khushitpratikshah/openear/enclosure/stl/pod_exploded.png

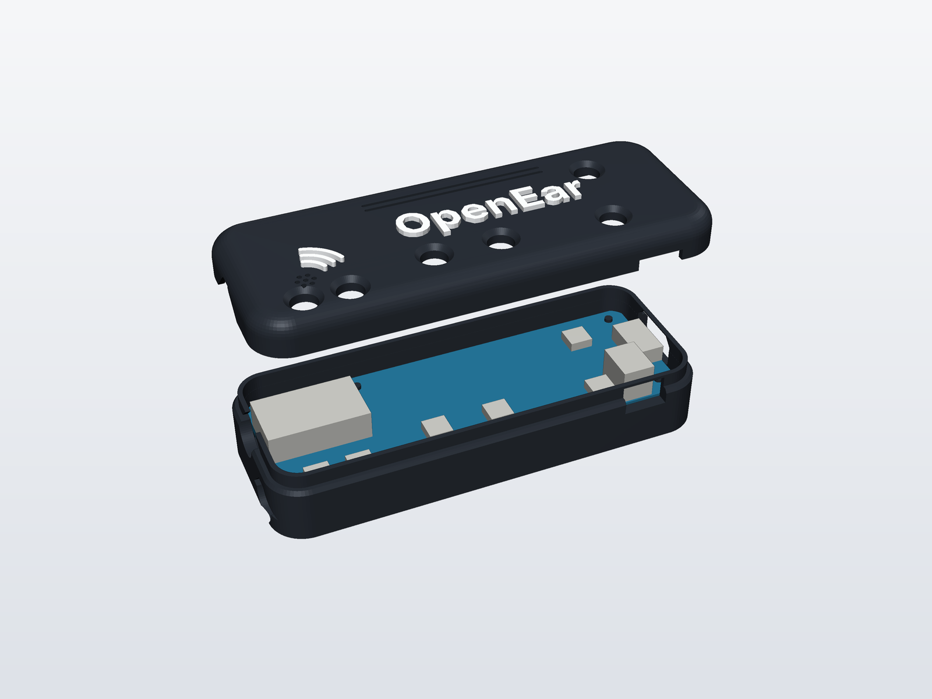
enclosure/stl/pod_exploded.png
