khushitpratikshah/openear/enclosure/stl/pod_hero.png

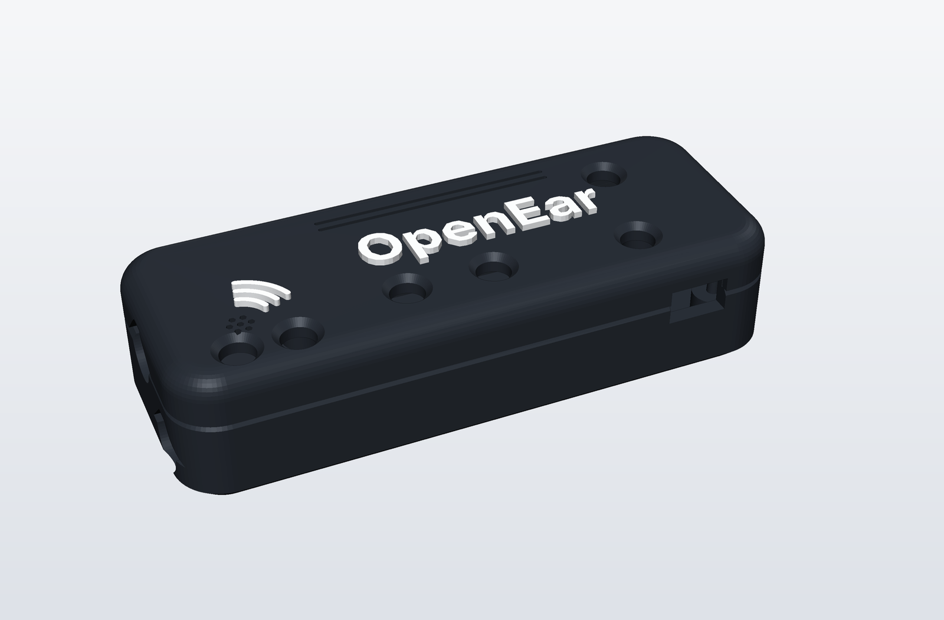
enclosure/stl/pod_hero.png
