khushitpratikshah/openear/diagrams/late_blocks.png

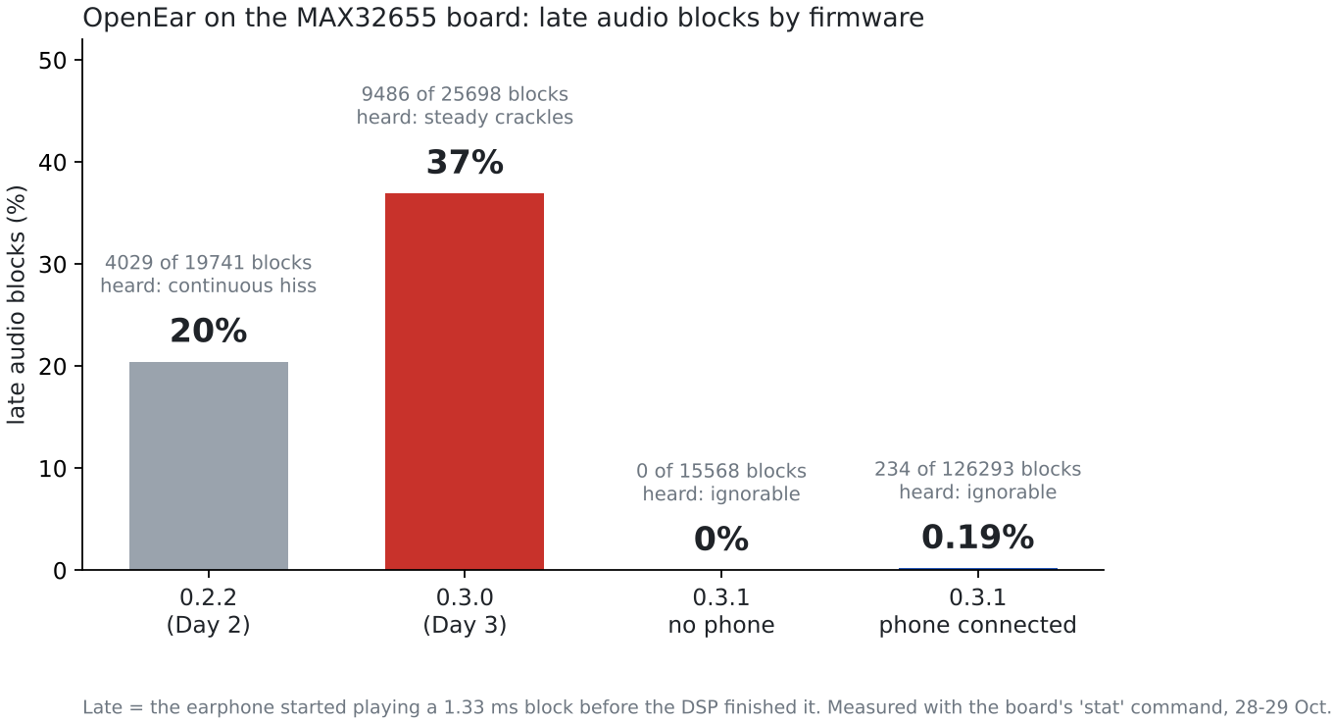
diagrams/late_blocks.png
