khushitpratikshah/openear/diagrams/latency.png

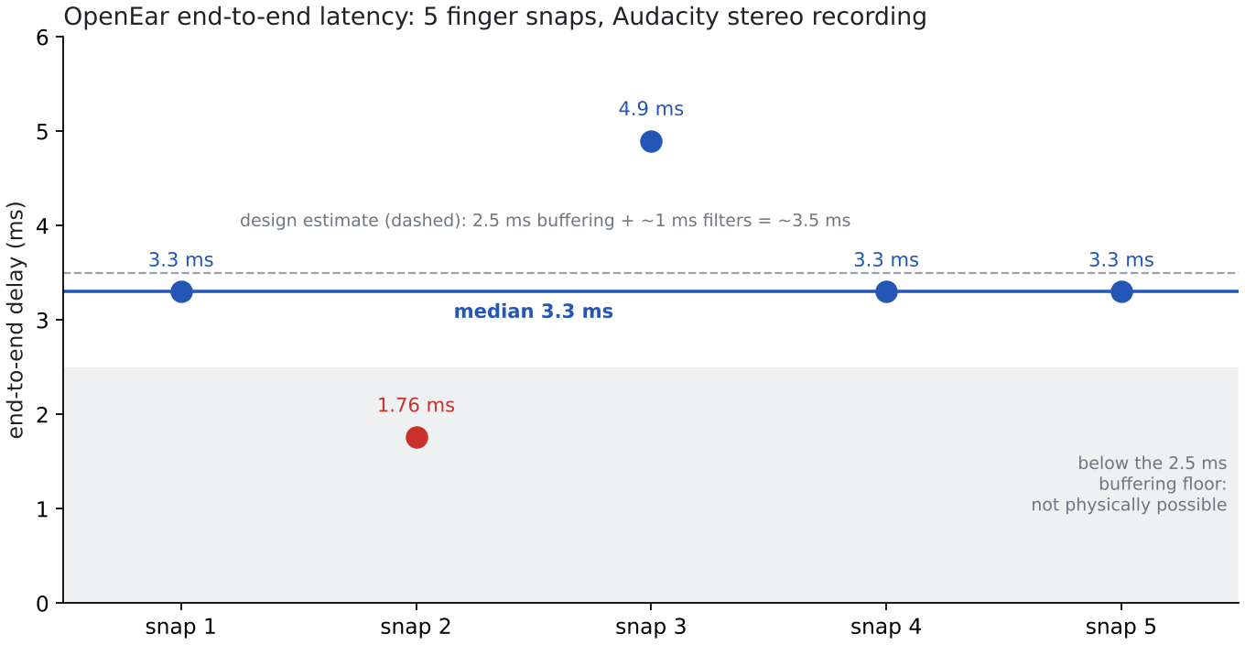
diagrams/latency.png
