khushitpratikshah/openear/diagrams/phase_lock.png

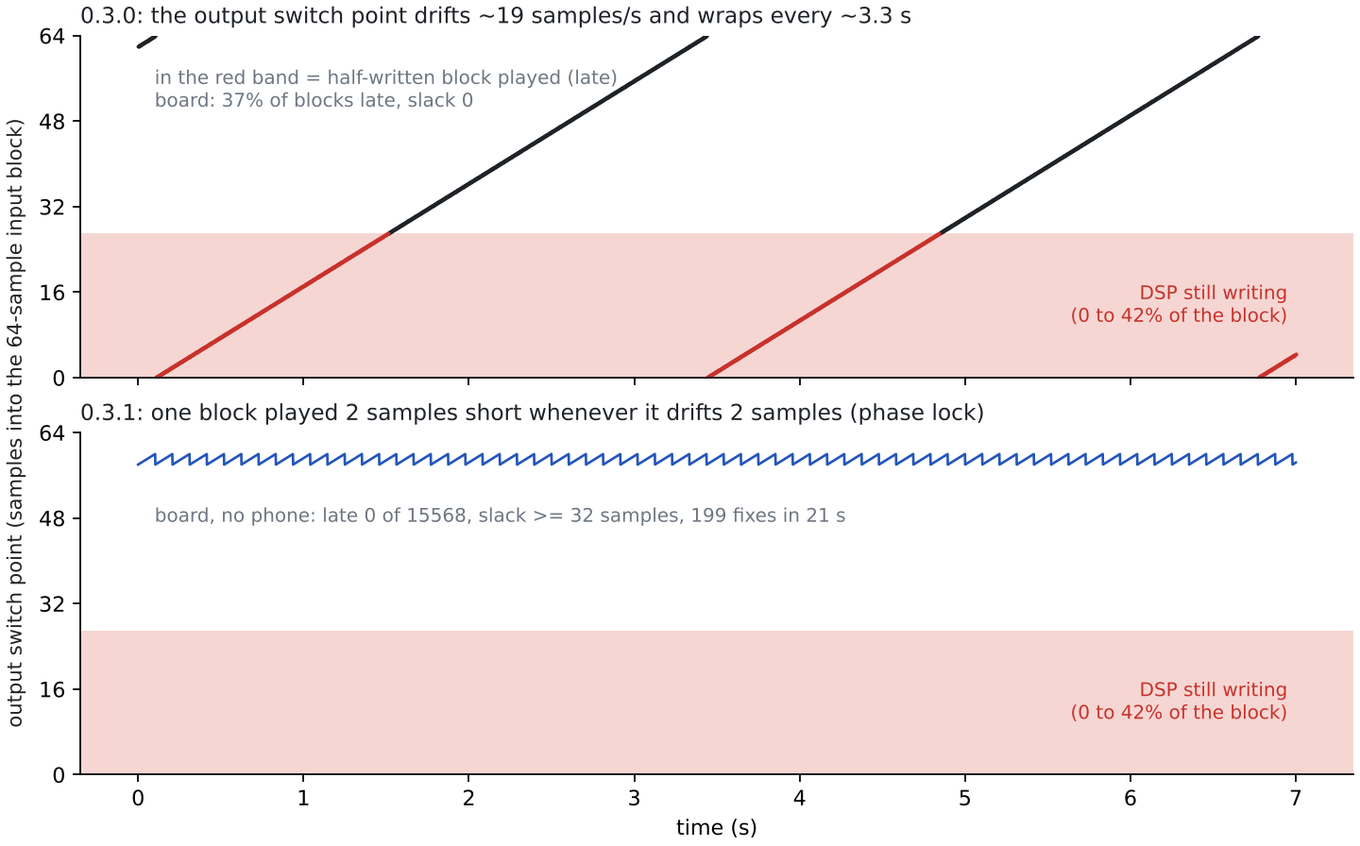
diagrams/phase_lock.png
