khushitpratikshah/openear/diagrams/signal_flow.png

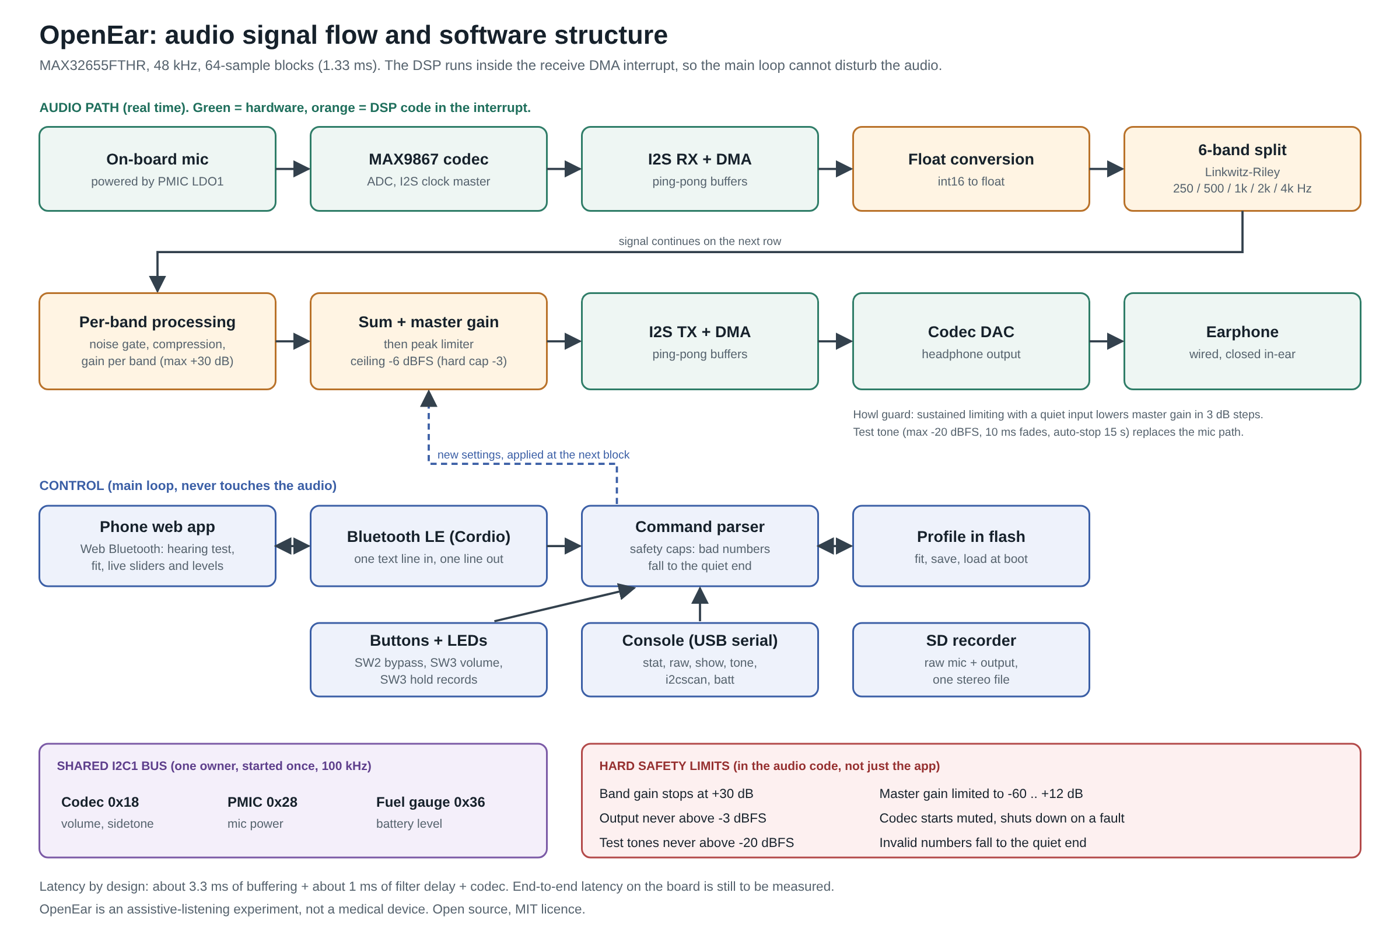
diagrams/signal_flow.png
