khushitpratikshah/openear/enclosure/stl/pod_back.png

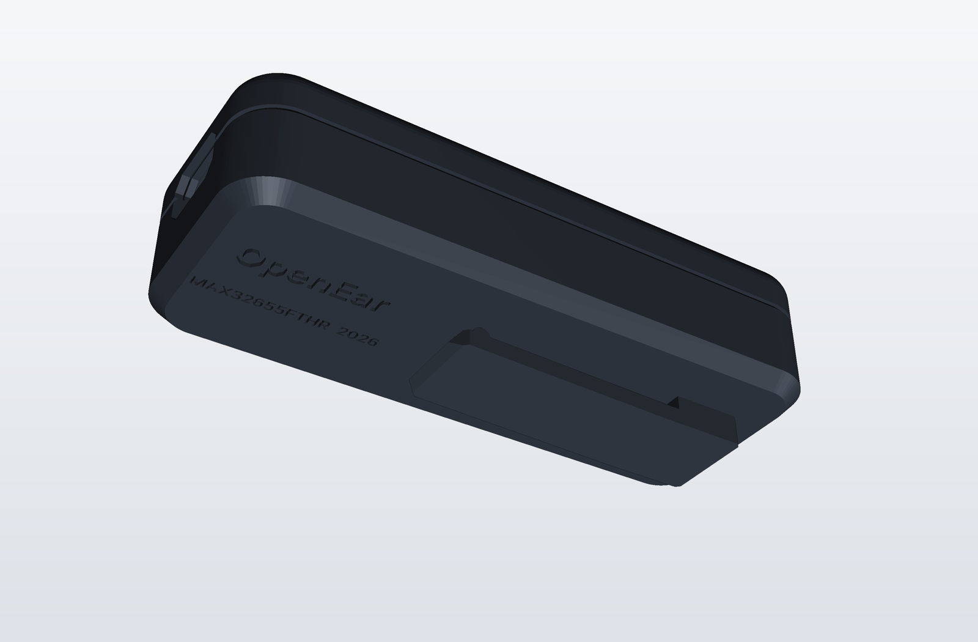
enclosure/stl/pod_back.png
