khushitpratikshah/openear/enclosure/stl/pod_top.png

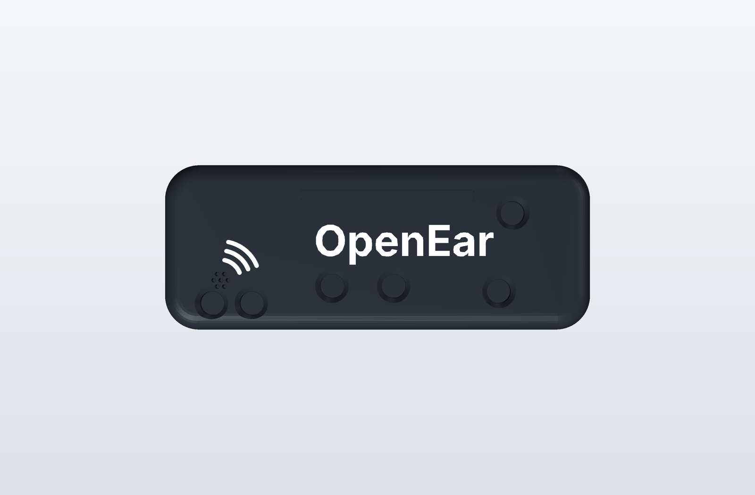
enclosure/stl/pod_top.png
