khushitpratikshah/openear/enclosure/stl/preview.png

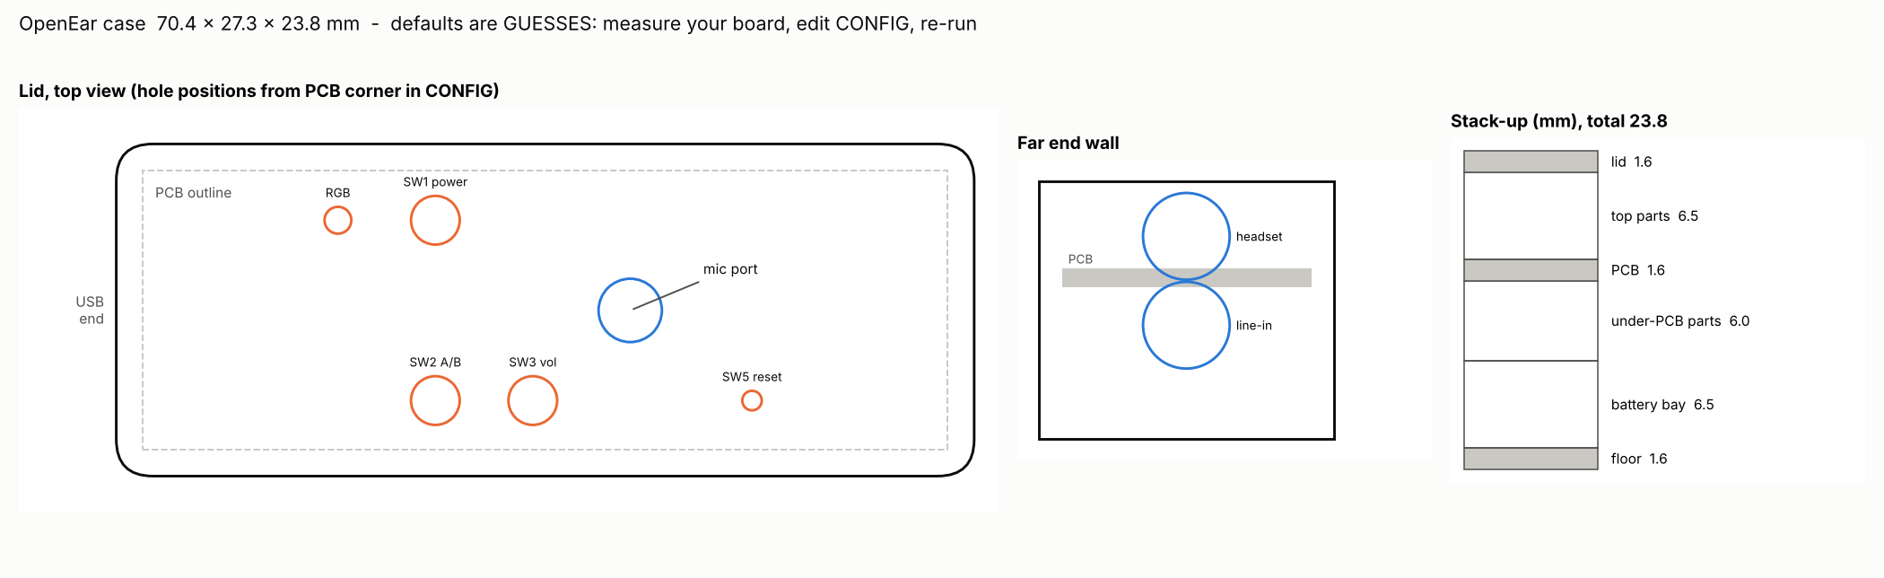
enclosure/stl/preview.png
