khushitpratikshah/openear/enclosure/stl/openear_pod_clip.stl

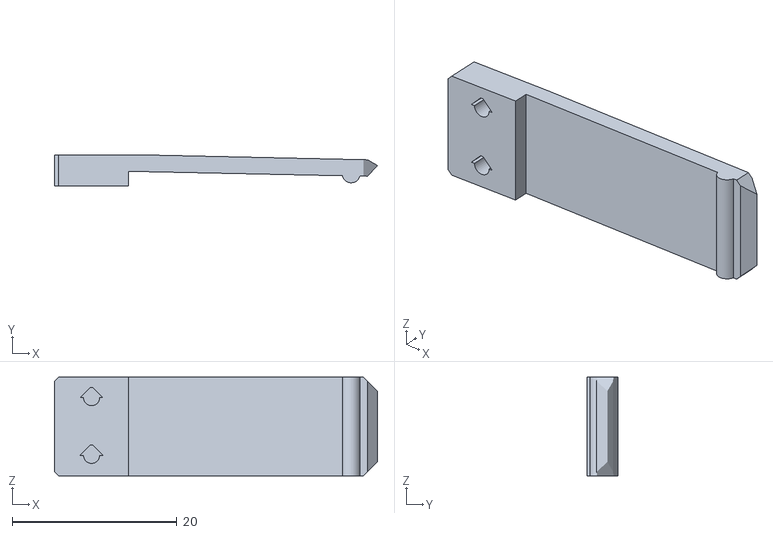
[picture p10: CAD file, 2026-11-01]
enclosure/stl/openear_pod_clip.stl
39.2 x 3.80 x 12.0
