khushitpratikshah/openear/enclosure/stl/openear_pod_base.stl

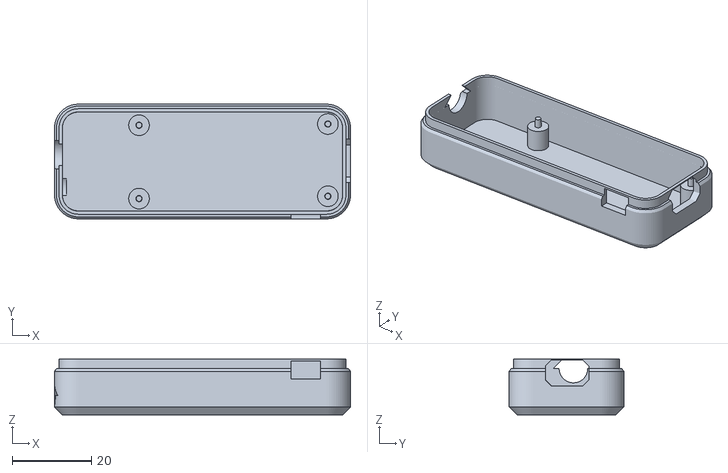
[picture p11: CAD file, 2026-11-01]
enclosure/stl/openear_pod_base.stl
74.6 x 28.9 x 14.1
