khushitpratikshah/openear/enclosure/stl/openear_pod_lid.stl

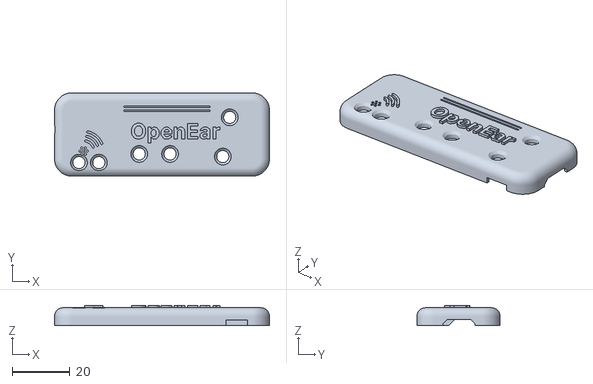
[picture p12: CAD file, 2026-11-01]
enclosure/stl/openear_pod_lid.stl
74.6 x 28.9 x 7.00
