khushitpratikshah/openear/enclosure/stl/openear_tray.stl

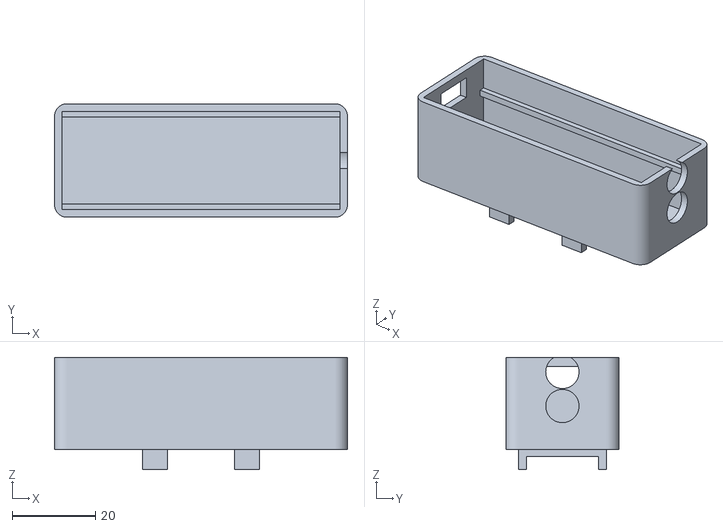
[picture p13: CAD file, 2026-10-30]
enclosure/stl/openear_tray.stl
70.4 x 27.3 x 27.0
