khushitpratikshah/openear/enclosure/stl/openear_lid.stl

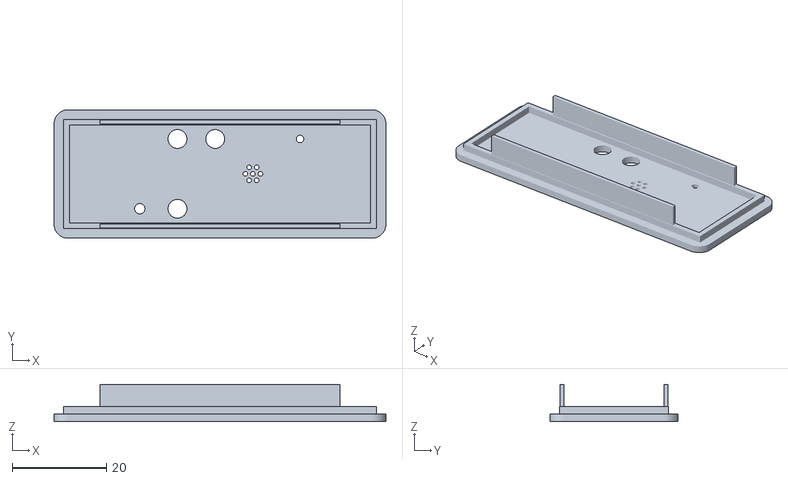
[picture p14: CAD file, 2026-10-30]
enclosure/stl/openear_lid.stl
70.4 x 27.3 x 7.90
