khushitpratikshah/openear/enclosure/stl/openear_fitcheck.stl

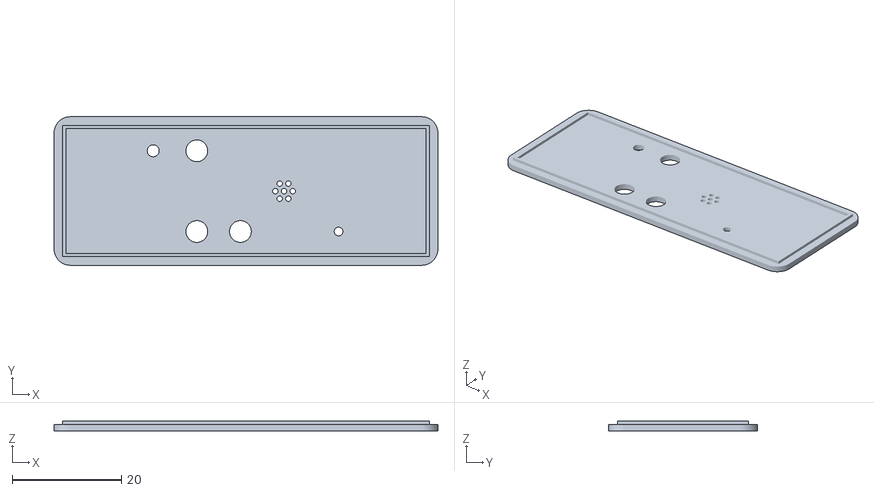
[picture p15: CAD file, 2026-10-30]
enclosure/stl/openear_fitcheck.stl
70.4 x 27.3 x 1.80
