khushitpratikshah/openear/dsp_test/demo_signal.csv

in | out
-0.000317 | -0.000076
-0.000336 | 0.000130
-0.000004 | 0.000119
0.000064 | -0.000194
-0.000073 | -0.000192
-0.000161 | 0.000052
0.000129 | 0.000246
0.000632 | 0.000113
0.000584 | -0.000232
0.000276 | -0.000083
0.000307 | 0.000270
0.000725 | 0.000231
0.000705 | -0.000254
0.000513 | -0.000280
0.000304 | -0.000094
0.000732 | 0.000170
0.000499 | -0.000251
0.000726 | 0.000043
0.000964 | 0.000049
0.001369 | 0.000108
0.001995 | 0.000163
0.001872 | -0.000051
0.001983 | 0.000361
0.002155 | 0.000407
0.002379 | 0.000192
0.002581 | -0.000105
0.002946 | -0.000258
0.003208 | -0.000420
0.003626 | -0.000325
0.003830 | -0.000303
0.003734 | -0.000161
0.004177 | 0.000256
0.004691 | 0.000136
0.005241 | -0.000015
0.005093 | -0.000204
0.004825 | 0.000161
0.004660 | 0.000425
0.005149 | 0.000457
0.005717 | -0.000057
0.005822 | -0.000466
0.006308 | -0.000102
0.006239 | -0.000075
0.006111 | 0.000264
0.005941 | 0.000406
0.006021 | 0.000363
0.006009 | -0.000015
0.006579 | -0.000105
0.006725 | -0.000521
0.007228 | -0.000260
0.007350 | -0.000209
0.007232 | 0.000069
0.007709 | 0.000510
0.008033 | 0.000245
0.008337 | 0.000071
0.008324 | -0.000056
0.008226 | 0.000075
0.008103 | 0.000184
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
