khushitpratikshah/openear/dsp_test/fitted_response.csv

freq_hz | gain_db
50.0 | 5.0010
54.5 | 5.0536
59.5 | 5.0176
64.8 | 4.9989
70.7 | 5.0833
77.1 | 5.0486
84.1 | 5.0504
91.7 | 5.0072
100.0 | 5.0325
109.0 | 5.0831
118.9 | 5.0719
129.7 | 5.0928
141.4 | 5.1280
154.2 | 5.1598
168.2 | 5.2566
183.4 | 5.3084
200.0 | 5.4186
218.1 | 5.5432
237.8 | 5.6950
259.3 | 5.8731
282.8 | 6.0803
308.4 | 6.3143
336.3 | 6.6150
366.7 | 6.9195
399.9 | 7.3001
436.1 | 7.7204
475.6 | 8.1908
518.6 | 8.6797
565.6 | 9.2288
616.8 | 9.8059
672.6 | 10.4241
733.4 | 11.0812
799.8 | 11.7963
872.2 | 12.5514
951.1 | 13.3322
1037.2 | 14.1408
1131.1 | 14.9562
1233.4 | 15.7884
1345.1 | 16.6340
1466.8 | 17.4957
1599.5 | 18.3772
1744.3 | 19.2632
1902.2 | 20.1482
2074.3 | 20.9992
2262.0 | 21.8119
2466.8 | 22.5757
2690.0 | 23.2977
2933.4 | 23.9861
3198.9 | 24.6506
3488.4 | 25.2920
3804.1 | 25.9023
4148.4 | 26.4682
4523.8 | 26.9736
4933.2 | 27.4046
5379.7 | 27.7561
5866.5 | 28.0333
6397.5 | 28.2433
6976.4 | 28.3990
7607.8 | 28.5111
8296.3 | 28.5908
9047.1 | 28.6460
9865.9 | 28.6840
10758.7 | 28.7077
11732.4 | 28.7252
12794.2 | 28.7364
13952.1 | 28.7418
15214.7 | 28.7461
