khushitpratikshah/openear/dsp_test/flat_response.csv

freq_hz | gain_db
50.0 | -0.0011
54.5 | 0.0506
59.5 | 0.0133
64.8 | -0.0072
70.7 | 0.0748
77.1 | 0.0364
84.1 | 0.0334
91.7 | -0.0167
100.0 | -0.0012
109.0 | 0.0359
118.9 | 0.0060
129.7 | 0.0009
141.4 | 0.0010
154.2 | -0.0146
168.2 | 0.0198
183.4 | -0.0091
200.0 | -0.0010
218.1 | -0.0020
237.8 | -0.0013
259.3 | -0.0014
282.8 | -0.0019
308.4 | -0.0092
336.3 | 0.0115
366.7 | -0.0082
399.9 | 0.0005
436.1 | 0.0008
475.6 | 0.0065
518.6 | -0.0092
565.6 | -0.0009
616.8 | -0.0009
672.6 | -0.0000
733.4 | -0.0055
799.8 | -0.0001
872.2 | 0.0025
951.1 | -0.0022
1037.2 | -0.0002
1131.1 | -0.0040
1233.4 | -0.0015
1345.1 | 0.0004
1466.8 | -0.0002
1599.5 | 0.0009
1744.3 | -0.0024
1902.2 | 0.0015
2074.3 | -0.0013
2262.0 | -0.0003
2466.8 | -0.0008
2690.0 | -0.0000
2933.4 | 0.0001
3198.9 | 0.0007
3488.4 | 0.0007
3804.1 | -0.0002
4148.4 | -0.0003
4523.8 | 0.0006
4933.2 | 0.0010
5379.7 | 0.0003
5866.5 | 0.0006
6397.5 | 0.0000
6976.4 | 0.0000
7607.8 | -0.0001
8296.3 | 0.0002
9047.1 | 0.0003
9865.9 | 0.0006
10758.7 | -0.0009
11732.4 | 0.0001
12794.2 | 0.0007
13952.1 | -0.0004
15214.7 | -0.0001
