khushitpratikshah/openear/dsp_test/group_delay.csv

freq_hz | delay_ms
100.0 | 3.7613
109.0 | 3.8002
118.9 | 3.8406
129.7 | 3.8804
141.4 | 3.9165
154.2 | 3.9442
168.2 | 3.9577
183.4 | 3.9502
200.0 | 3.9148
218.1 | 3.8467
237.8 | 3.7441
259.3 | 3.6103
282.8 | 3.4525
308.4 | 3.2799
336.3 | 3.1012
366.8 | 2.9226
400.0 | 2.7467
436.2 | 2.5739
475.6 | 2.4037
518.7 | 2.2365
565.6 | 2.0739
616.8 | 1.9182
672.6 | 1.7715
733.5 | 1.6349
799.9 | 1.5080
872.3 | 1.3895
951.2 | 1.2779
1037.3 | 1.1723
1131.1 | 1.0728
1233.5 | 0.9798
1345.1 | 0.8939
1466.9 | 0.8152
1599.6 | 0.7430
1744.4 | 0.6765
1902.3 | 0.6146
2074.4 | 0.5566
2262.2 | 0.5024
2466.9 | 0.4520
2690.1 | 0.4058
2933.6 | 0.3635
3199.1 | 0.3249
3488.6 | 0.2894
3804.3 | 0.2563
4148.6 | 0.2251
4524.1 | 0.1960
4933.5 | 0.1690
5380.0 | 0.1444
5866.9 | 0.1226
6397.8 | 0.1035
6976.8 | 0.0872
7608.2 | 0.0735
8296.8 | 0.0620
9047.6 | 0.0525
9866.4 | 0.0446
10759.4 | 0.0381
11733.1 | 0.0327
