khushitpratikshah/openear/dsp_test/howl_guard.csv

t_s | out_rms_dbfs | howl_atten_db
0.0000 | -81.54 | 0.0
0.0107 | -11.66 | 0.0
0.0213 | -23.31 | 0.0
0.0320 | -25.25 | 0.0
0.0427 | -19.94 | 0.0
0.0533 | -14.44 | 0.0
0.0640 | -17.44 | 0.0
0.0747 | -13.67 | 0.0
0.0853 | -13.78 | 0.0
0.0960 | -14.19 | 0.0
0.1067 | -15.12 | 0.0
0.1173 | -14.92 | 0.0
0.1280 | -17.62 | 0.0
0.1387 | -12.85 | 0.0
0.1493 | -19.86 | 0.0
0.1600 | -16.59 | 0.0
0.1707 | -16.37 | 0.0
0.1813 | -14.02 | 0.0
0.1920 | -18.47 | 0.0
0.2027 | -17.37 | 0.0
0.2133 | -16.47 | 0.0
0.2240 | -17.46 | 0.0
0.2347 | -14.99 | 0.0
0.2453 | -19.98 | 0.0
0.2560 | -16.31 | 0.0
0.2667 | -16.19 | 0.0
0.2773 | -14.55 | 0.0
0.2880 | -16.32 | 0.0
0.2987 | -15.44 | 0.0
0.3093 | -14.56 | 0.0
0.3200 | -17.36 | 0.0
0.3307 | -13.31 | 0.0
0.3413 | -20.82 | 0.0
0.3520 | -20.31 | 0.0
0.3627 | -13.48 | 0.0
0.3733 | -14.35 | 0.0
0.3840 | -14.42 | 0.0
0.3947 | -18.89 | 0.0
0.4053 | -14.67 | 0.0
0.4160 | -17.36 | 0.0
0.4267 | -16.08 | 0.0
0.4373 | -14.73 | 0.0
0.4480 | -15.60 | 0.0
0.4587 | -14.88 | 0.0
0.4693 | -20.84 | 0.0
0.4800 | -17.25 | 0.0
0.4907 | -14.35 | 0.0
0.5013 | -14.55 | 0.0
0.5120 | -16.29 | 3.0
0.5227 | -27.49 | 3.0
0.5333 | -29.74 | 3.0
0.5440 | -22.82 | 3.0
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
