khushitpratikshah/openear/dsp_test/impulse.csv

ms | amplitude
0.0000 | 0.238556
0.0208 | -0.662713
0.0417 | 0.323547
0.0625 | 0.326404
0.0833 | 0.066214
0.1042 | -0.139315
0.1250 | -0.205539
0.1458 | -0.158152
0.1667 | -0.056716
0.1875 | 0.045104
0.2083 | 0.114455
0.2292 | 0.139939
0.2500 | 0.125816
0.2708 | 0.084733
0.2917 | 0.031578
0.3125 | -0.020596
0.3333 | -0.062589
0.3542 | -0.089494
0.3750 | -0.100154
0.3958 | -0.096151
0.4167 | -0.080708
0.4375 | -0.057726
0.4583 | -0.031073
0.4792 | -0.004111
0.5000 | 0.020539
0.5208 | 0.041062
0.5417 | 0.056413
0.5625 | 0.066197
0.5833 | 0.070534
0.6042 | 0.069917
0.6250 | 0.065081
0.6458 | 0.056893
0.6667 | 0.046262
0.6875 | 0.034074
0.7083 | 0.021147
0.7292 | 0.008198
0.7500 | -0.004174
0.7708 | -0.015492
0.7917 | -0.025402
0.8125 | -0.033664
0.8333 | -0.040141
0.8542 | -0.044789
0.8750 | -0.047636
0.8958 | -0.048772
0.9167 | -0.048336
0.9375 | -0.046498
0.9583 | -0.043449
0.9792 | -0.039394
1.0000 | -0.034539
1.0208 | -0.029086
1.0417 | -0.023227
1.0625 | -0.017141
1.0833 | -0.010989
1.1042 | -0.004915
1.1250 | 0.000958
1.1458 | 0.006525
1.1667 | 0.011702
1.1875 | 0.016421
1.2083 | 0.020633
1.2292 | 0.024303
1.2500 | 0.027411
1.2708 | 0.029949
1.2917 | 0.031921
1.3125 | 0.033339
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
