khushitpratikshah/openear/diagrams/day5_results.png

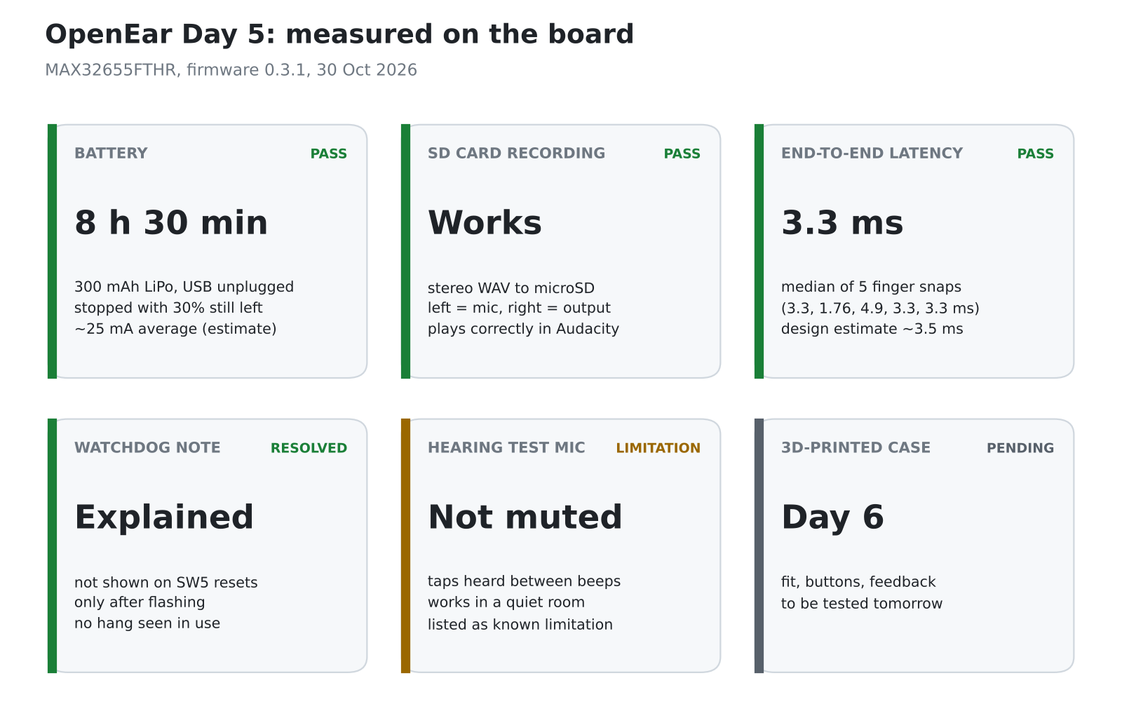
diagrams/day5_results.png
