khushitpratikshah/openear/(commit log)

2026-10-30 Initial commit: OpenEar v0.3.1
    [demo_signal.csv, fitted_response.csv, flat_response.csv, group_delay.csv, howl_guard.csv, impulse.csv, io_curve.csv, openear_fitcheck.stl]
2026-11-01 Add OpenEar pod enclosure design, 3D models, renders, and documentation
    [openear_pod_base.stl, openear_pod_clip.stl, openear_pod_lid.stl]
